AloeVeraZ/eye_bot/assets/grabcad-render.png

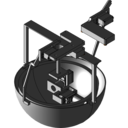
assets/grabcad-render.png
