AloeVeraZ/eye_bot/cad/Perfect circle 200 test v9.step

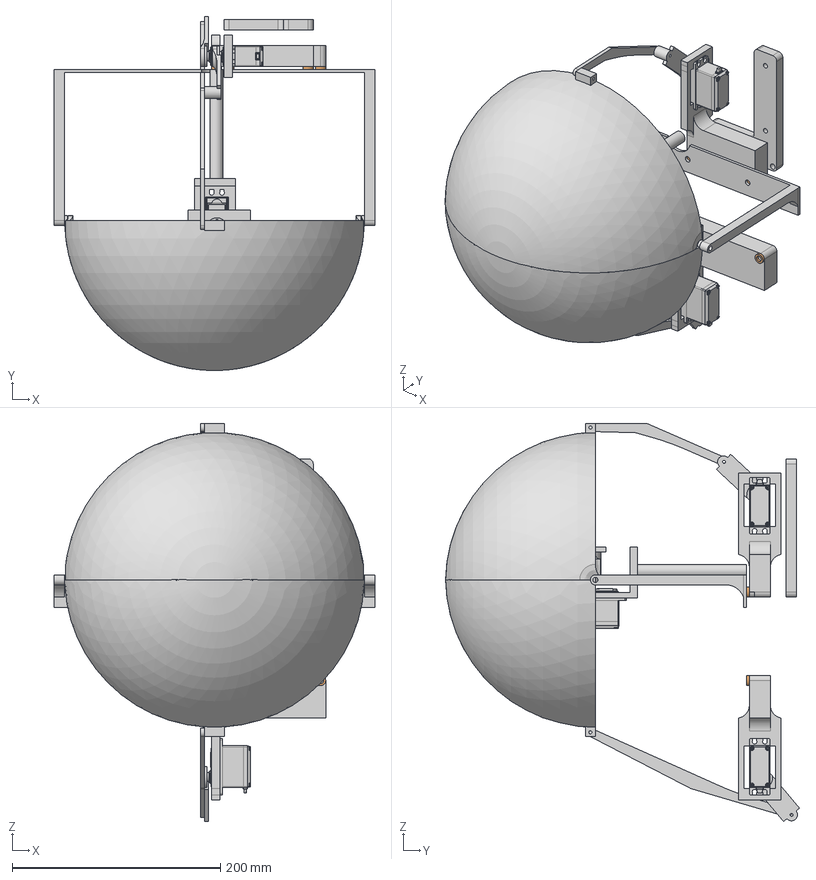
[picture p5: CAD file, 2026-08-02]
cad/Perfect circle 200 test v9.step
308.0 x 340.0 x 382.3 mm
DA LONG SPACER
